LeemanGeophysicalLLC/OpAmps_Demo_PCB/README.md

# OpAmps_Demo_PCB
Basic Op-Amp Circuit Demo PCB
