LeemanGeophysicalLLC/OpAmps_Demo_PCB/Renders/pcb_back.png

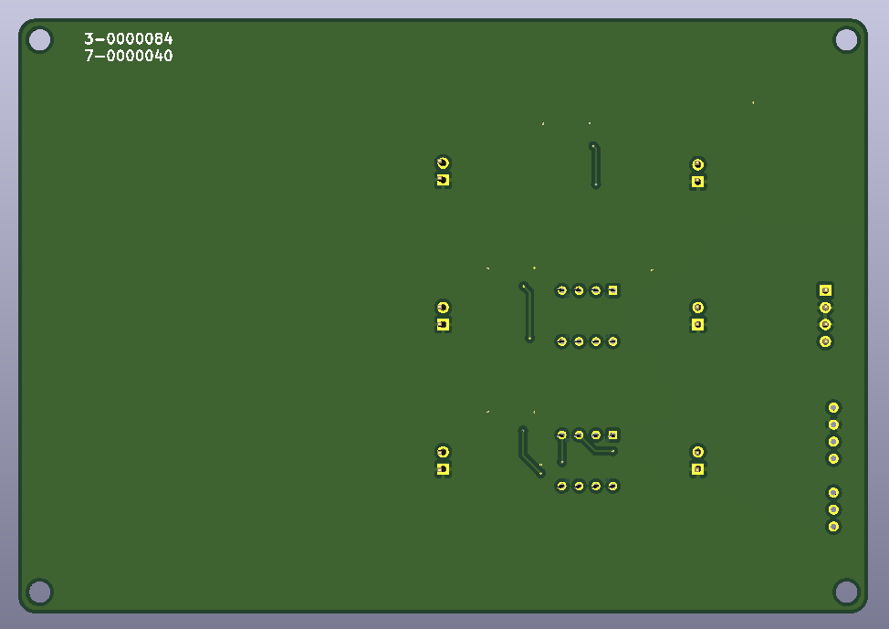
Renders/pcb_back.png
