LeemanGeophysicalLLC/OpAmps_Demo_PCB/Renders/pcb_front.png

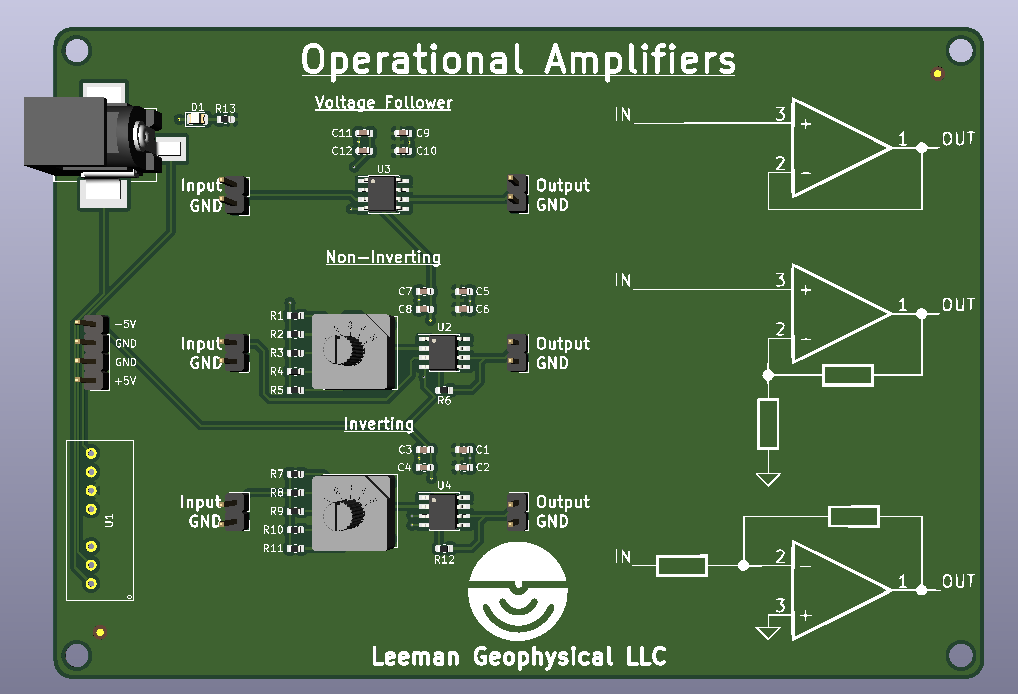
Renders/pcb_front.png
