LeemanGeophysicalLLC/OpAmps_Demo_PCB/PDFs/schematic.pdf

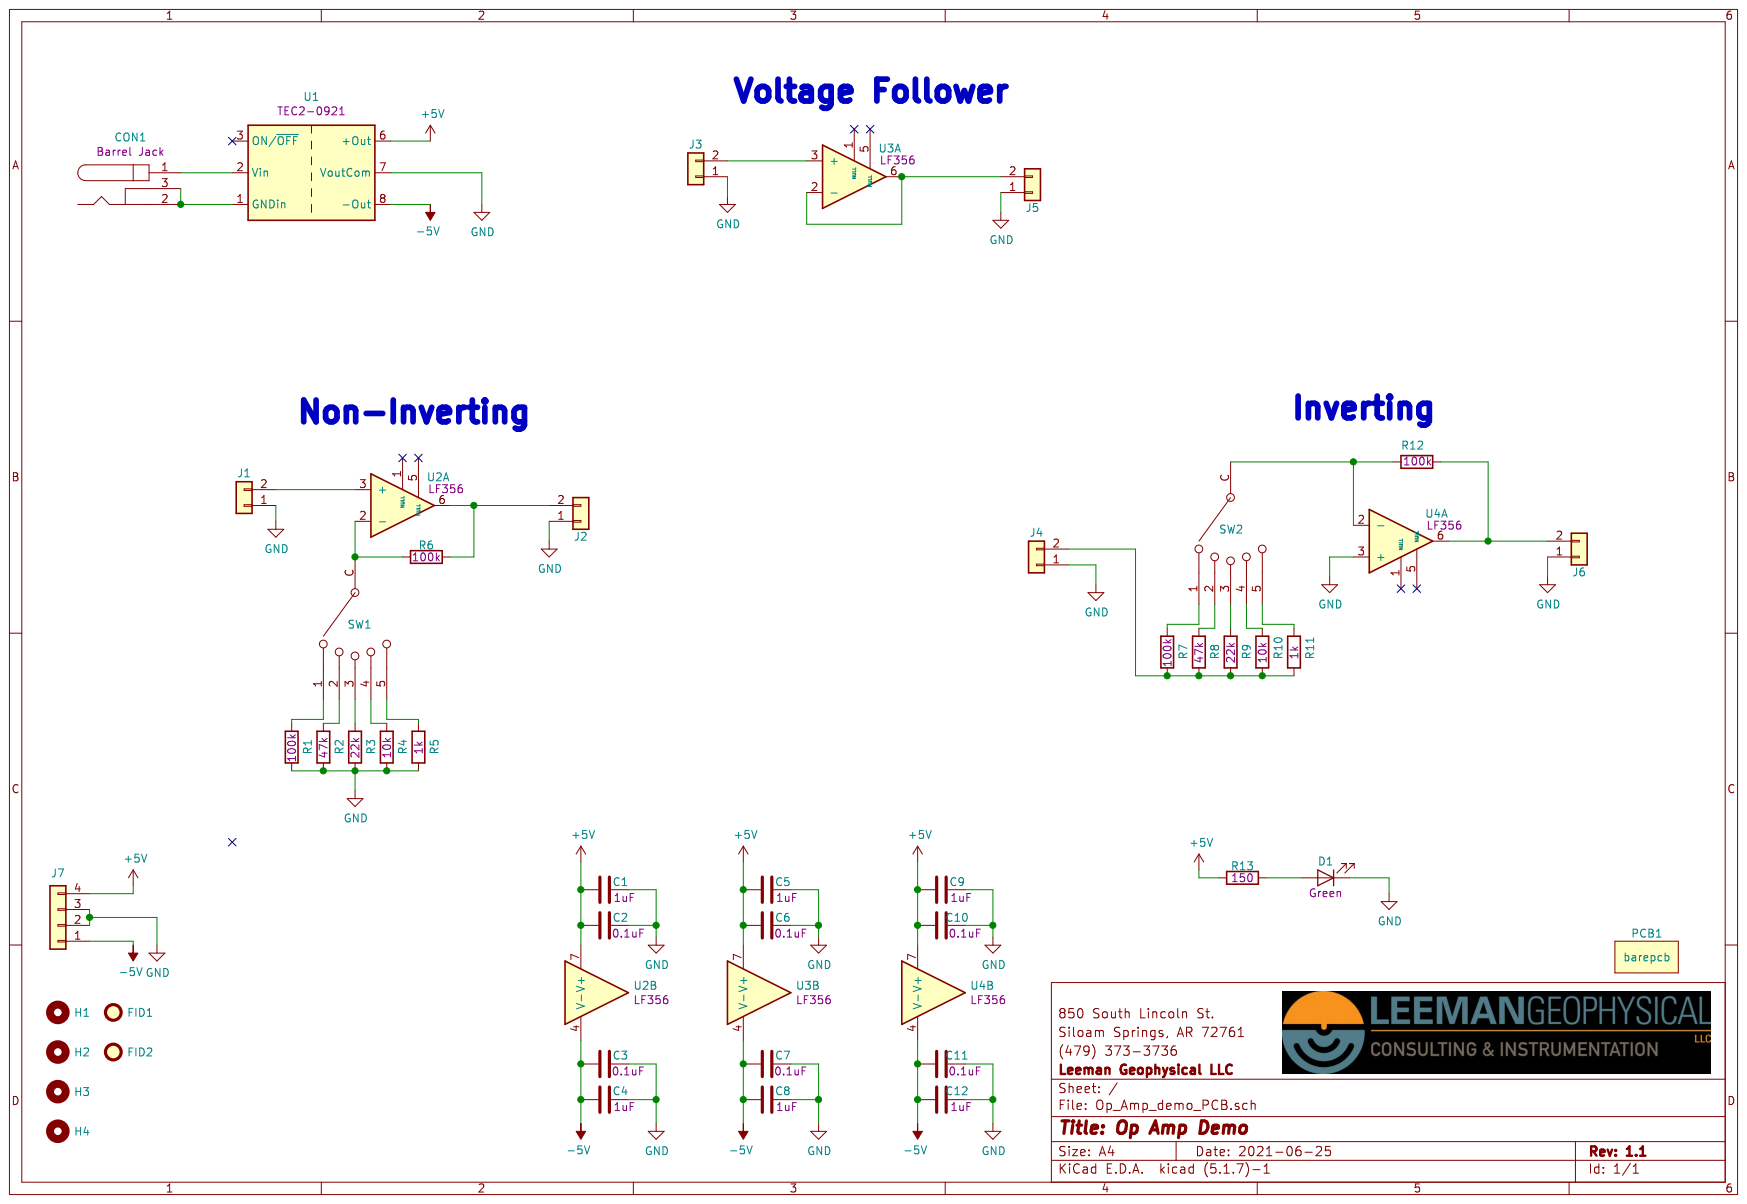
[picture p3: page 1]
