LeemanGeophysicalLLC/OpAmps_Demo_PCB/PDFs/pcb.pdf

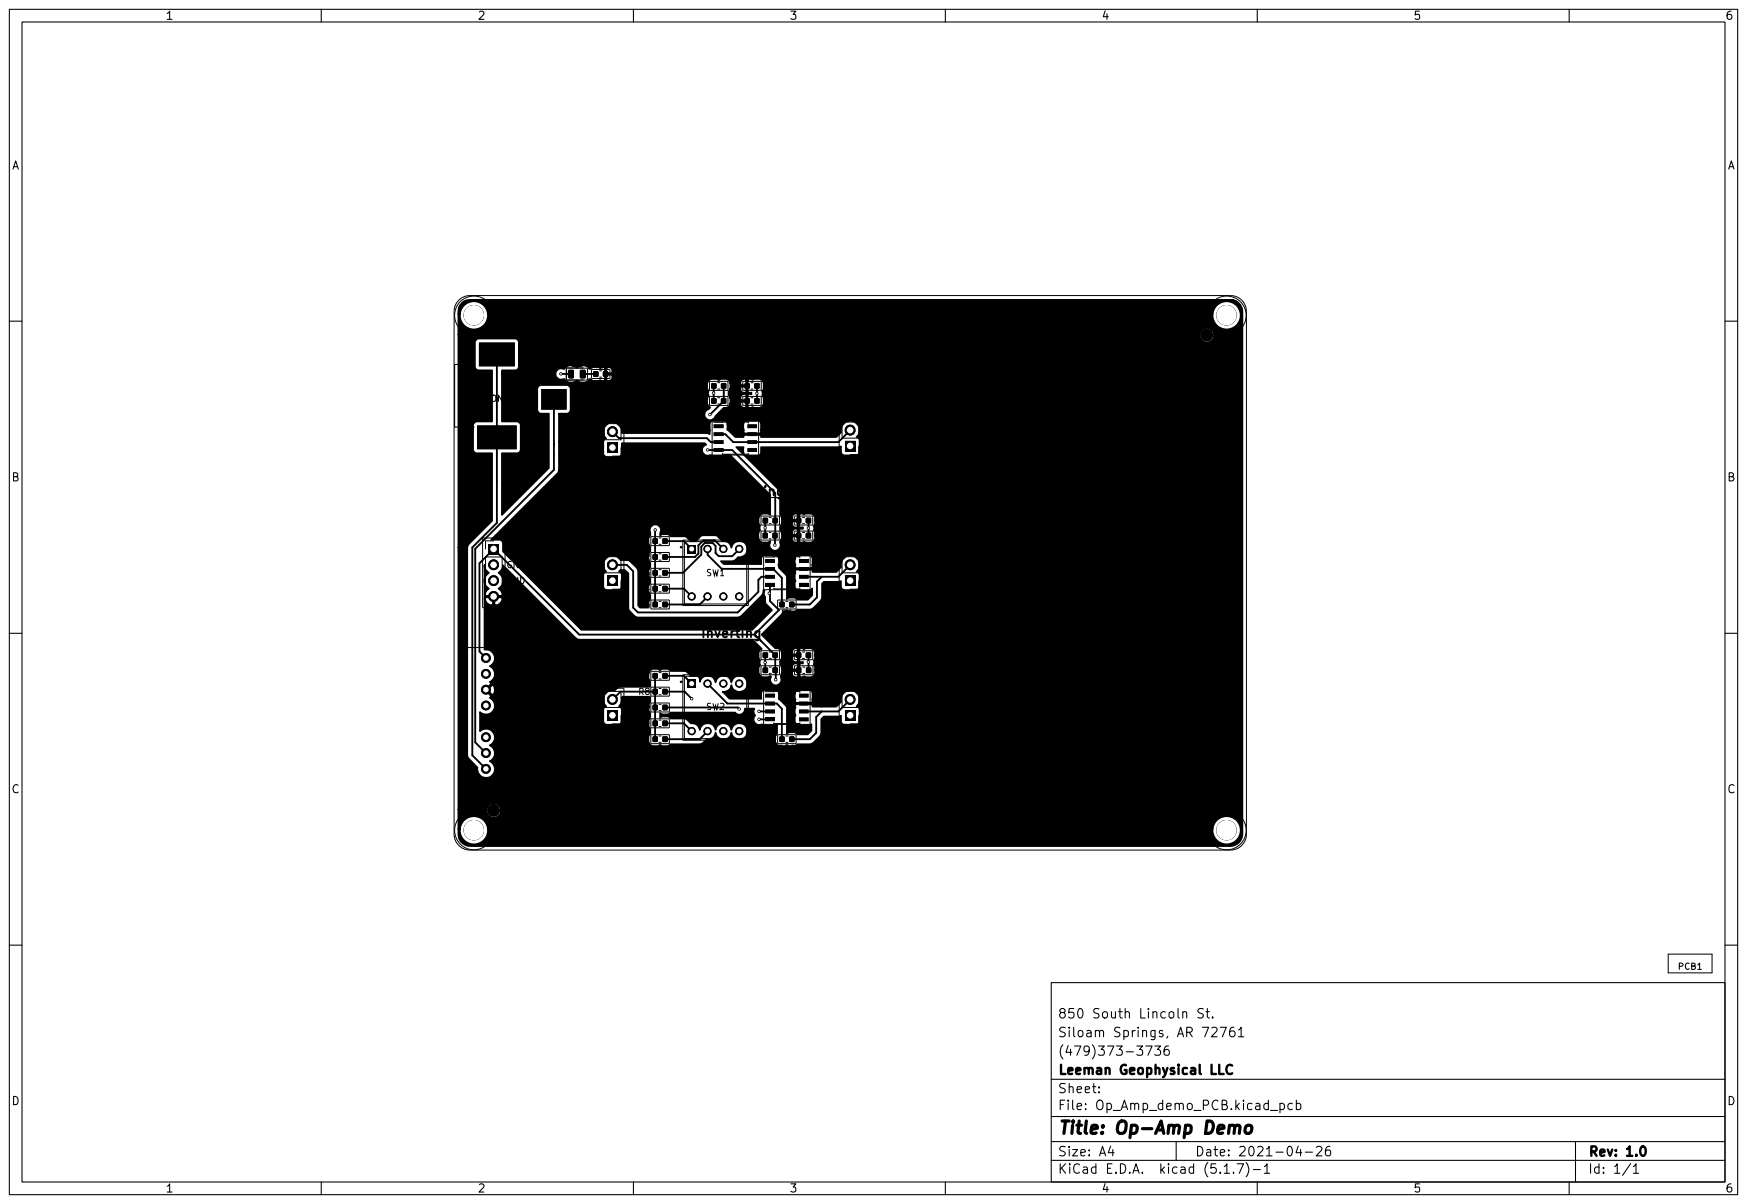
[picture p4: page 1]
