LeemanGeophysicalLLC/OpAmps_Demo_PCB/(threads)

Thread 2 (2021-06-25):

Input labels incorrect

jrleeman, 2021-06-25:
Voltage follower and inverting amp have reversed input labels.

jrleeman, 2021-06-25:
Closed in master

Closed 2021-06-25.
