LeemanGeophysicalLLC/OpAmps_Demo_PCB/(commit log)

2021-04-21 Initial schematic capture
    [Op_Amp_demo_PCB.kicad_pcb, Op_Amp_demo_PCB.sch]
2021-04-26 Tweaks and production files.
    [KiCAD_raw_BOM.csv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]
2021-06-25 Rev 1.1 with silk screen and header orientation fixes
    [KiCAD_raw_BOM.csv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]
2021-06-25 Minor tweaks for Rev 1.1 production
    [Op_Amp_demo_PCB-B_Cu.gbr, Op_Amp_demo_PCB-B_Mask.gbr, Op_Amp_demo_PCB-B_Paste.gbr, Op_Amp_demo_PCB-B_SilkS.gbr, Op_Amp_demo_PCB-Edge_Cuts.gbr, Op_Amp_demo_PCB-F_Cu.gbr, Op_Amp_demo_PCB-F_Mask.gbr, Op_Amp_demo_PCB-F_Paste.gbr]
